charkster/mux_board_v1/kicad/mux_board_v1_sch_plot.pdf

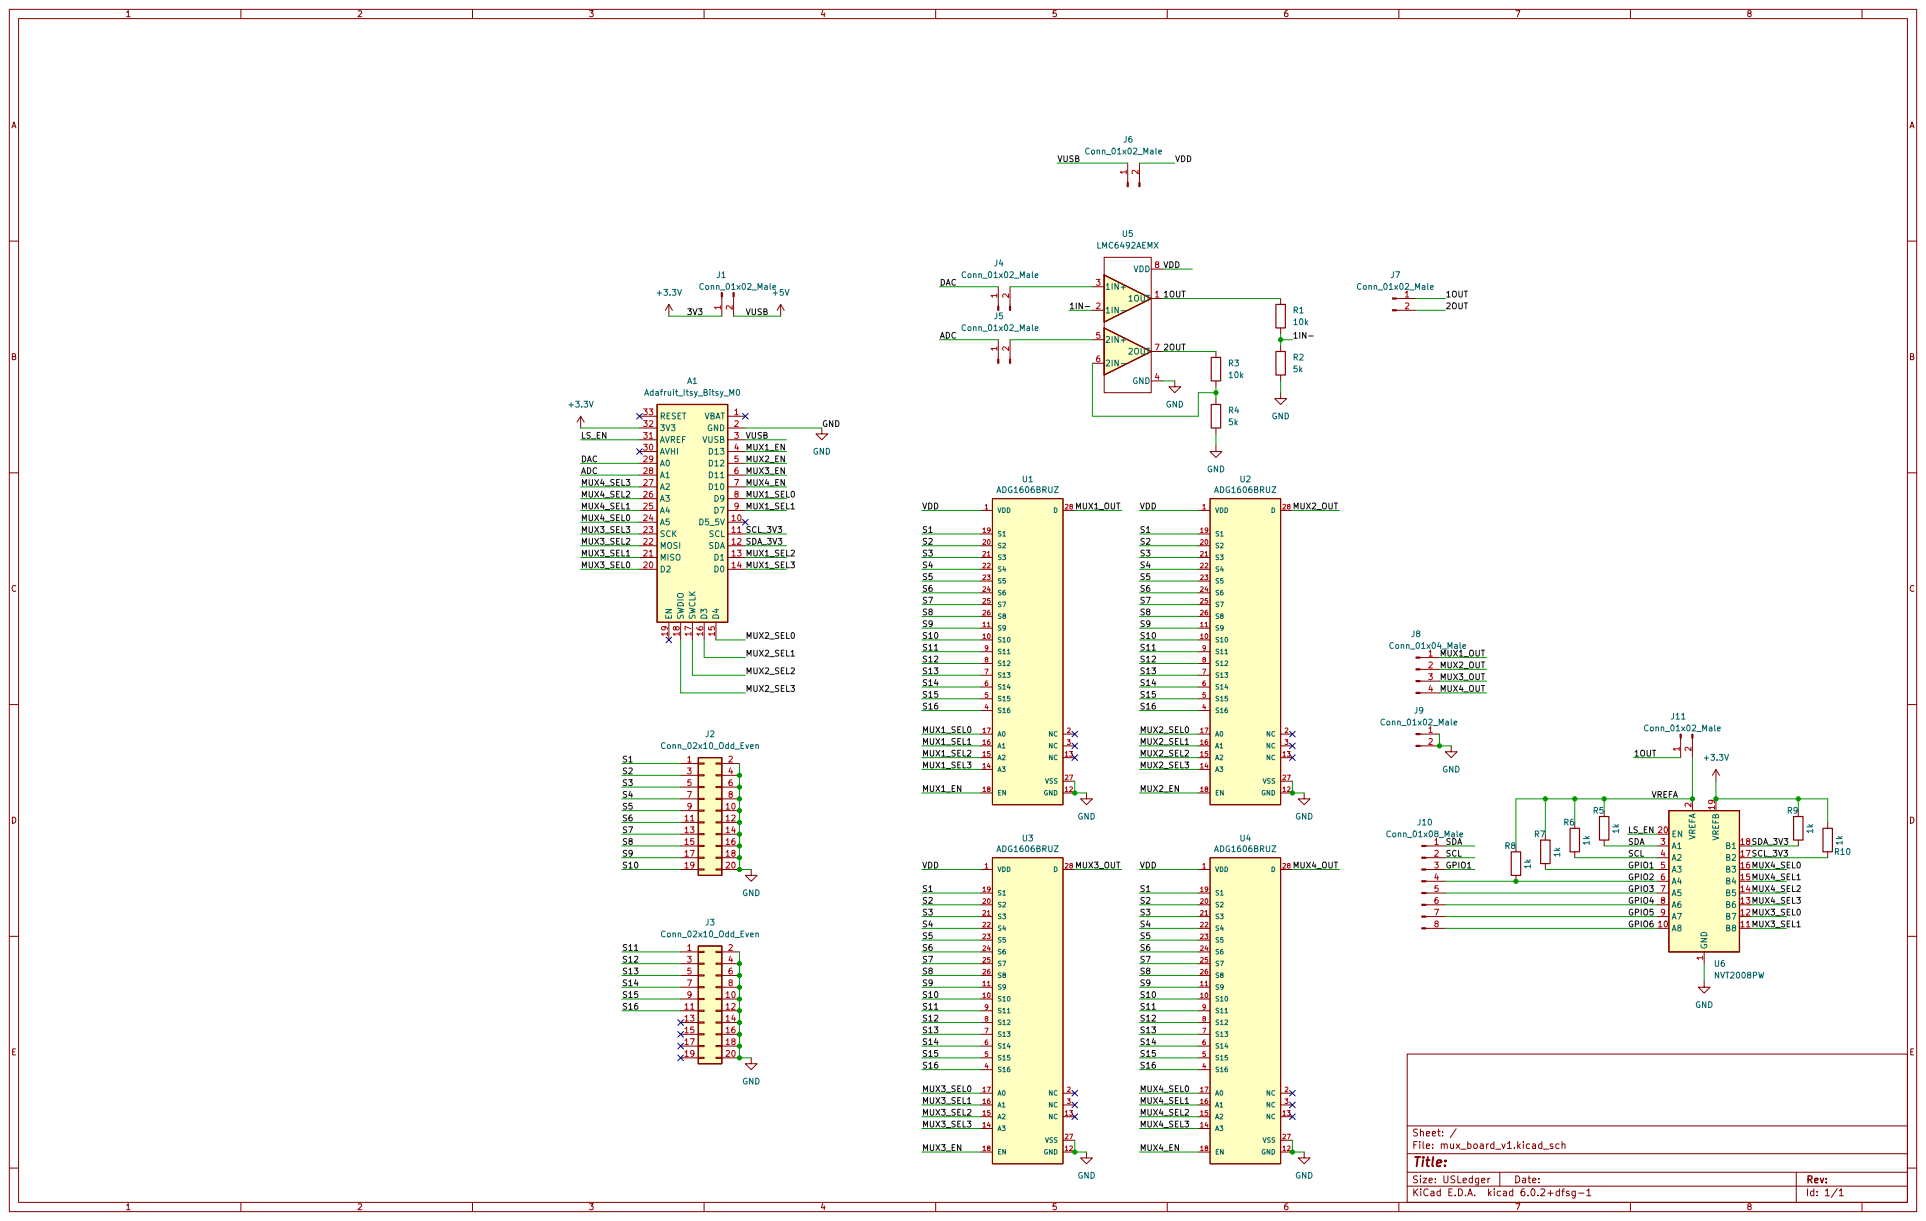
[picture p2: page 1]
