charkster/mux_board_v1/kicad/mux_board_v1.kicad_pcb

## KiCad design kicad/mux_board_v1.kicad_pcb (2022-10-04)

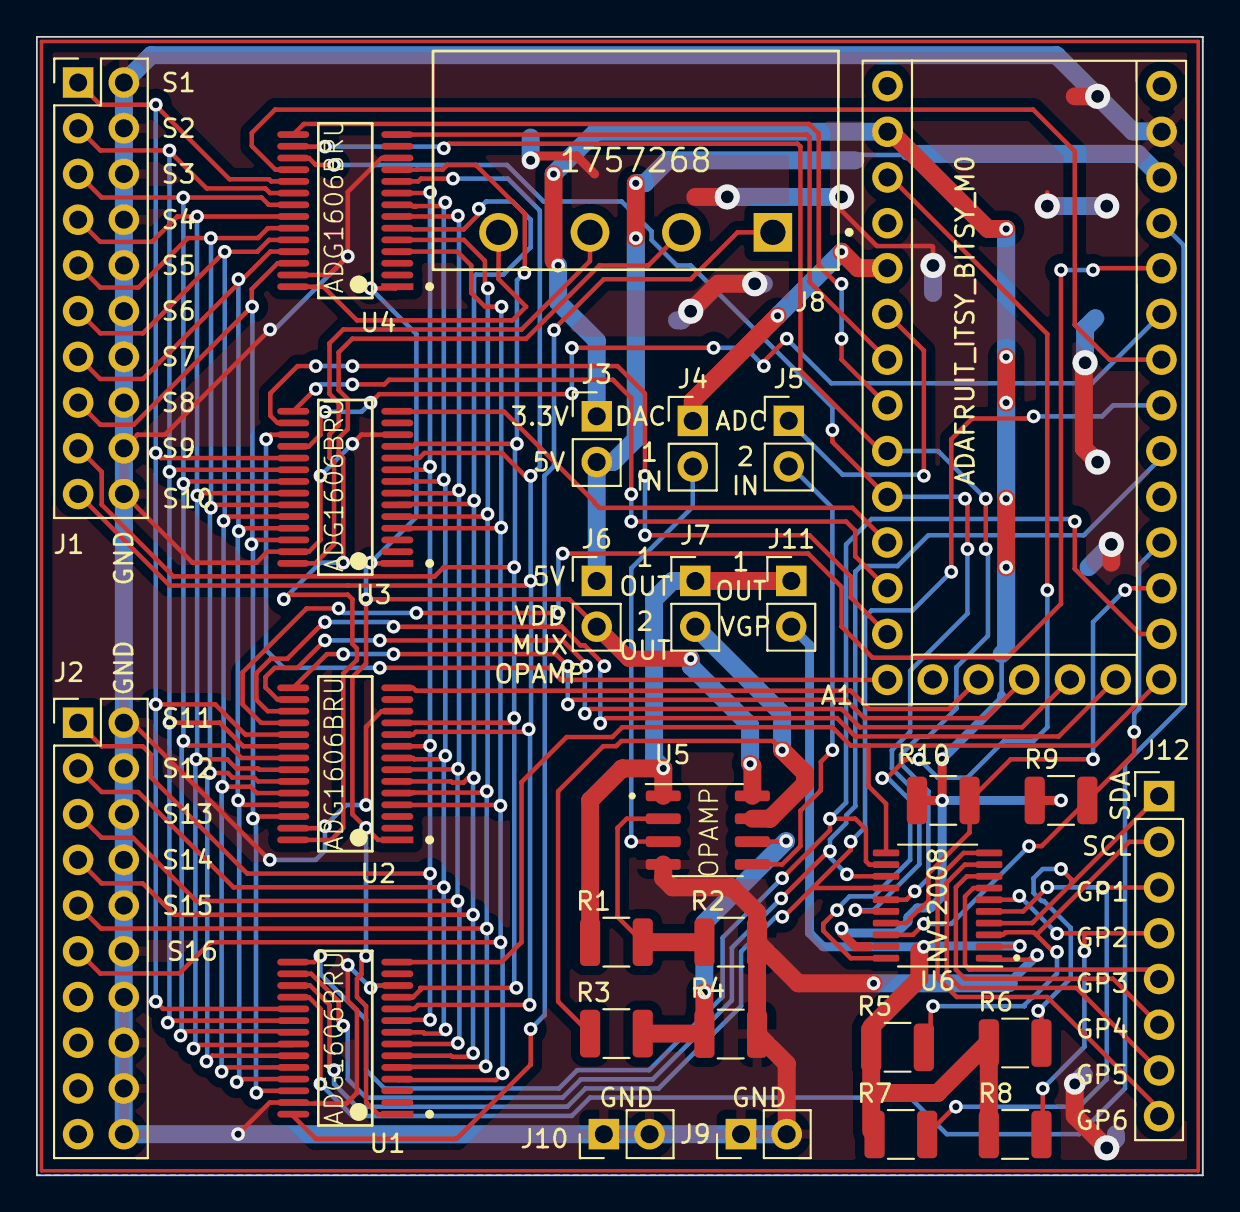
[picture p3: board mux_board_v1.kicad_pcb from above]

Board: 2 copper layers, 64.8 x 63.2 mm, 29 parts (0 on the bottom side), 64 nets.

Parts:
A1: ADAFRUIT_ITSY_BITSY_M0; Adafruit_Itsy_Bitsy_M0
J1, J2: Conn_02x10_Odd_Even; PinHeader_2x10_P2.54mm_Vertical
J3, J4, J5, J6, J7, J9, J10, J11: Conn_01x02_Male; PinHeader_1x02_P2.54mm_Vertical
J8: 1757268; Phoenix_Contact-1757268-0
J12: Conn_01x08_Male; PinHeader_1x08_P2.54mm_Vertical
R1, R3: 10k; R_1210_3225Metric
R2, R4: 5k; R_1210_3225Metric
R5, R6, R7, R8, R9, R10: 1k; R_1210_3225Metric
U1, U2, U3, U4: ADG1606BRU; Analog_Devices-RU-28-0-0-IPC_A
U5: OPAMP; SOIC-8-1EP_3.9x4.9mm_P1.27mm_EP2.29x3mm
U6: NVT2008; TSSOP-20_4.4x6.5mm_P0.65mm

Connections:
+3V3: A1.32 (3V3), J3.1, R9.1, R10.1, U6.19 (VREFB)
+5V: A1.3 (VUSB), J3.2, J6.1
/1IN-: R1.2, R2.1, U5.2 (1IN-)
/1OUT: J7.1, J11.1, R1.1, U5.1 (1OUT)
/2OUT: J7.2, R3.1, U5.7 (2OUT)
/ADC: A1.28 (A1), J5.1
/DAC: A1.29 (A0), J4.1
/GPIO1: J12.3, R7.2, U6.5 (A3)
/GPIO2: J12.4, R8.2, U6.6 (A4)
/GPIO3: J12.5, U6.7 (A5)
/GPIO4: J12.6, U6.8 (A6)
/GPIO5: J12.7, U6.9 (A7)
/GPIO6: J12.8, U6.10 (A8)
/LS_EN: A1.31 (AVREF), U6.20 (EN)
/MUX1_EN: A1.4 (D13), U1.18 (EN)
/MUX1_OUT: J8.1, U1.28 (D)
/MUX1_SEL0: A1.8 (D9), U1.17 (A0), U6.14 (B5)
/MUX1_SEL1: A1.9 (D7), U1.16 (A1), U6.13 (B6)
/MUX1_SEL2: A1.13 (D1), U1.15 (A2), U6.12 (B7)
/MUX1_SEL3: A1.14 (D0), U1.14 (A3), U6.11 (B8)
/MUX2_EN: A1.5 (D12), U2.18 (EN)
/MUX2_OUT: J8.2, U2.28 (D)
/MUX2_SEL0: A1.15 (D4), U2.17 (A0)
/MUX2_SEL1: A1.16 (D3), U2.16 (A1)
/MUX2_SEL2: A1.17 (SWCLK), U2.15 (A2)
/MUX2_SEL3: A1.18 (SWDIO), U2.14 (A3)
/MUX3_EN: A1.6 (D11), U3.18 (EN)
/MUX3_OUT: J8.3, U3.28 (D)
/MUX3_SEL0: A1.20 (D2), U3.17 (A0)
/MUX3_SEL1: A1.21 (MISO), U3.16 (A1)
/MUX3_SEL2: A1.22 (MOSI), U3.15 (A2)
/MUX3_SEL3: A1.23 (SCK), U3.14 (A3)
/MUX4_EN: A1.7 (D10), U4.18 (EN)
/MUX4_OUT: J8.4, U4.28 (D)
/MUX4_SEL0: A1.24 (A5), U4.17 (A0), U6.16 (B3)
/MUX4_SEL1: A1.25 (A4), U4.16 (A1), U6.15 (B4)
/MUX4_SEL2: A1.26 (A3), U4.15 (A2)
/MUX4_SEL3: A1.27 (A2), U4.14 (A3)
/S1: J1.1, U1.19 (S1), U2.19 (S1), U3.19 (S1), U4.19 (S1)
/S2: J1.3, U1.20 (S2), U2.20 (S2), U3.20 (S2), U4.20 (S2)
/S3: J1.5, U1.21 (S3), U2.21 (S3), U3.21 (S3), U4.21 (S3)
/S4: J1.7, U1.22 (S4), U2.22 (S4), U3.22 (S4), U4.22 (S4)
/S5: J1.9, U1.23 (S5), U2.23 (S5), U3.23 (S5), U4.23 (S5)
/S6: J1.11, U1.24 (S6), U2.24 (S6), U3.24 (S6), U4.24 (S6)
/S7: J1.13, U1.25 (S7), U2.25 (S7), U3.25 (S7), U4.25 (S7)
/S8: J1.15, U1.26 (S8), U2.26 (S8), U3.26 (S8), U4.26 (S8)
/S9: J1.17, U1.11 (S9), U2.11 (S9), U3.11 (S9), U4.11 (S9)
/S10: J1.19, U1.10 (S10), U2.10 (S10), U3.10 (S10), U4.10 (S10)
/S11: J2.1, U1.9 (S11), U2.9 (S11), U3.9 (S11), U4.9 (S11)
/S12: J2.3, U1.8 (S12), U2.8 (S12), U3.8 (S12), U4.8 (S12)
/S13: J2.5, U1.7 (S13), U2.7 (S13), U3.7 (S13), U4.7 (S13)
/S14: J2.7, U1.6 (S14), U2.6 (S14), U3.6 (S14), U4.6 (S14)
/S15: J2.9, U1.5 (S15), U2.5 (S15), U3.5 (S15), U4.5 (S15)
/S16: J2.11, U1.4 (S16), U2.4 (S16), U3.4 (S16), U4.4 (S16)
/SCL: J12.2, R5.2, U6.3 (A1)
/SCL_3V3: A1.11 (SCL), R9.2, U6.18 (B1)
/SDA: J12.1, R6.2, U6.4 (A2)
/SDA_3V3: A1.12 (SDA), R10.2, U6.17 (B2)
/VDD: J6.2, U1.1 (VDD), U2.1 (VDD), U3.1 (VDD), U4.1 (VDD), U5.8 (VDD)
/VREFA: J11.2, R5.1, R6.1, R7.1, R8.1, U6.2 (VREFA)
GND: A1.2 (GND), J1.2, J1.4, J1.6, J1.8, J1.10, J1.12, J1.14, J1.16, J1.18, J1.20, J2.2, J2.4, J2.6, J2.8, J2.10, J2.12, J2.14, J2.16, J2.18, J2.20, J9.1, J9.2, J10.1, J10.2, R2.2, R4.2, U1.12 (GND), U1.27 (VSS), U2.12 (GND), U2.27 (VSS), U3.12 (GND), U3.27 (VSS), U4.12 (GND), U4.27 (VSS), U5.4 (GND), U6.1 (GND)
unnamed: J4.2, U5.3 (1IN+)
unnamed: J5.2, U5.5 (2IN+)
unnamed: R3.2, R4.1, U5.6 (2IN-)
