charkster/mux_board_v1/tinyusb_usbtmc/usbtmc_app.h

#ifndef USBTMC_APP_H
#define USBTMC_APP_H

void     usbtmc_app_task_iter(void);

void     adc_setup(void);
void     dac_setup(void);
void     gpio_setup(void);
uint32_t adc_get_sample(void);

char * get_value(char *in_string);
char * get_command(char *in_string, char *ptr_value);
void ftoa(float num, char *str);

#endif
