charkster/mux_board_v1/(notices)

Notices in the files:
kicad/mux_board_v1.kicad_pcb:
creativecommons.org/licenses/by/4.0
License: CC BY 4.0
